AhmadR-HI/SoftRobotic_ME4242/README.md

# ME4242 Project

Group Project for ME4242, made with love

visit [site](https://ahmadr-hi.github.io/SoftRobotic_ME4242/)
