AhmadR-HI/SoftRobotic_ME4242/References.md

---
title: Reference
nav_order: 5
layout: default
---

## 5. References
- [1] A. Okamura, “ Growing Robots That Can be Used for Search and Rescue,” YouTube, https://www.youtube.com/watch?v=jlaNjPi4hCo (accessed Nov. 15, 2025).

- [2] F. Connolly, P. Polygerinos, C. J. Walsh, and K. Bertoldi, “Soft robot for tube navigation via fiber-based mechanical programming,” YouTube, https://www.youtube.com/watch?v=hvxlAbZ9bjM (accessed Nov. 15, 2025).

- [3] S.-A. Abad, A. Arezzo, S. Homer-Vanniasinkam, and H. A. Wurdemann, “Soft robotic systems for endoscopic interventions,” Endorobotics, pp. 61–93, Jan. 2022. doi:10.1016/b978-0-12-821750-4.00004-9

- [4] “Types of endoscopy procedures and their uses,” Curasia Endoscopy, https://www.curasia.com/types-of-endoscopy-procedures-and-their-uses/ (accessed Nov. 15, 2025).

- [5] Stanford CHARM Lab, “A Tip Mount for Transporting Sensors and Tools using Soft Growing Robots,” YouTube, Sep. 15, 2020. https://www.youtube.com/watch?v=bOOB3zELaj0 (accessed Nov. 16, 2025).

- [6] R. Niiyama et al., “Pouch Motors: Printable soft actuators integrated with computational design,” Pouch Motors: Printable Soft Actuators Integrated with Computational Design, https://dspace.mit.edu/handle/1721.1/107946 (accessed Nov. 15, 2025).

- [7] “PneuNets bending actuators: Soft Robotics Toolkit,” Harvard John A. Paulson School of Engineering and Applied Sciences, https://softroboticstoolkit.com/book/pneunets-bending-actuator (accessed Nov. 15, 2025). 

- [8] J. Gue et al., “Kirigami-inspired 3D printable soft pneumatic actuators with multiple deformation modes for soft robotic applications,” Soft robotics, https://pubmed.ncbi.nlm.nih.gov/36827310/ (accessed Nov. 15, 2025). 

- [9] A. Bernaldo, “What is TPU filament: An easy guide for smart 3D printing,” Siraya Tech, https://siraya.tech/blogs/news/what-is-tpu-filament#:~:text=Key%20Property:%20Its%20flexibility%20is,abrasion%2C%20oils%2C%20and%20tearing (accessed Nov. 15, 2025). 

- [10] Cincinnati Children’s, Double-Balloon Enteroscopy, Cincinnati Children’s, https://www.youtube.com/watch?v=f7B8UPv9raA (accessed Nov. 15, 2025).
