AhmadR-HI/SoftRobotic_ME4242/(commit log)

2025-11-28 Document Arduino code for airflow control
    Added Arduino code for controlling airflow and valves.
2025-11-28 Link Arduino code instead of displaying it
    Updated the Arduino code section to link to the code file instead of displaying it directly.
2025-11-28 edit on the arduino links
